gnxlxnxx/christmas_card_25/bell/bell-lib/2340901-1--3DModel-STEP-78480.STEP

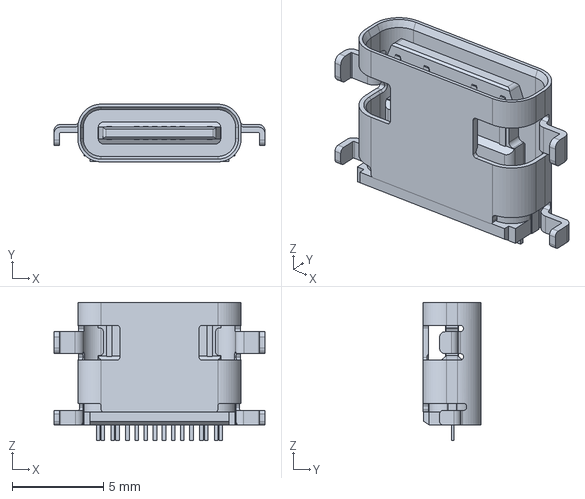
[picture p1: CAD file, 2025-12-08]
bell/bell-lib/2340901-1--3DModel-STEP-78480.STEP
11.5 x 3.16 x 7.55 mm
