gnxlxnxx/christmas_card_25/bell/bell.pdf

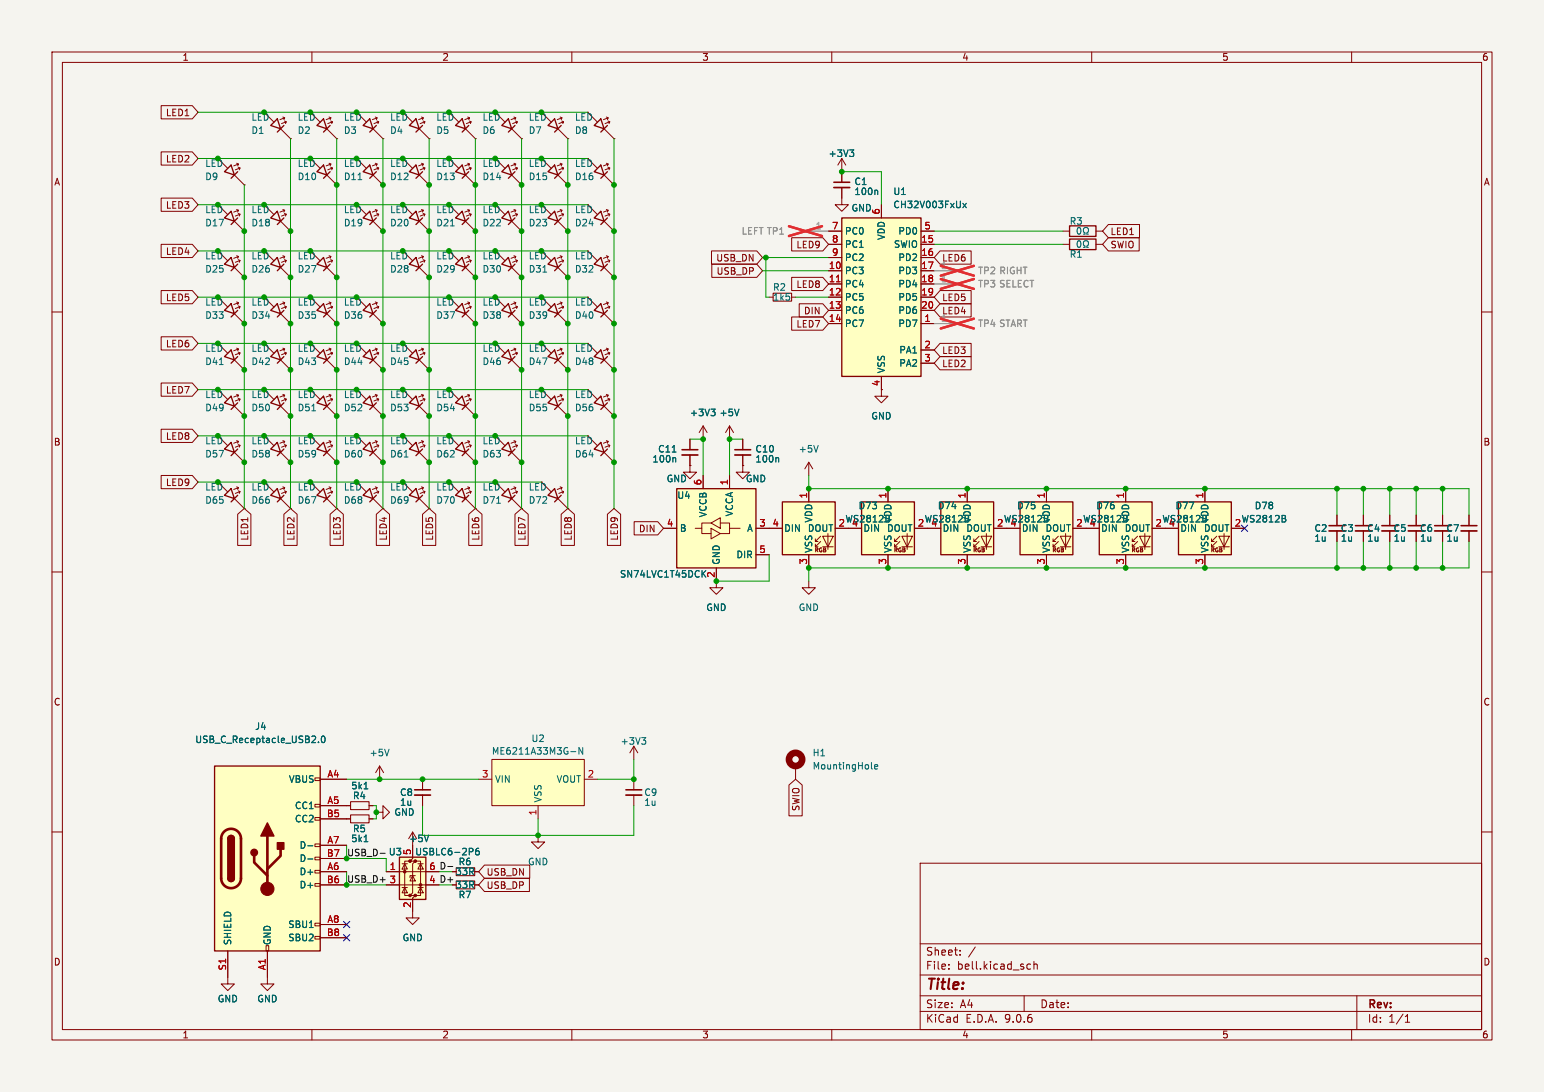
[picture p2: page 1]

4 PD0 5 SWIO 15 PD2 16 PD3 17 PD4 18 PD5 19 PD6 20 PD7 1 PA1 2 PA2 3 TP4 START 1 TP3 SELECT 1 TP2 RIGHT 1

3 DOUT 2 D74 WS2812B SHIELD S1 GND A1 VBUS A4 CC1 A5 CC2 B5 D- A7 D- B7 D+ A6 D+ B6 SBU1 A8 SBU2 B8
