gnxlxnxx/christmas_card_25/bell/bell.kicad_pcb

## KiCad design bell/bell.kicad_pcb (2025-12-26)

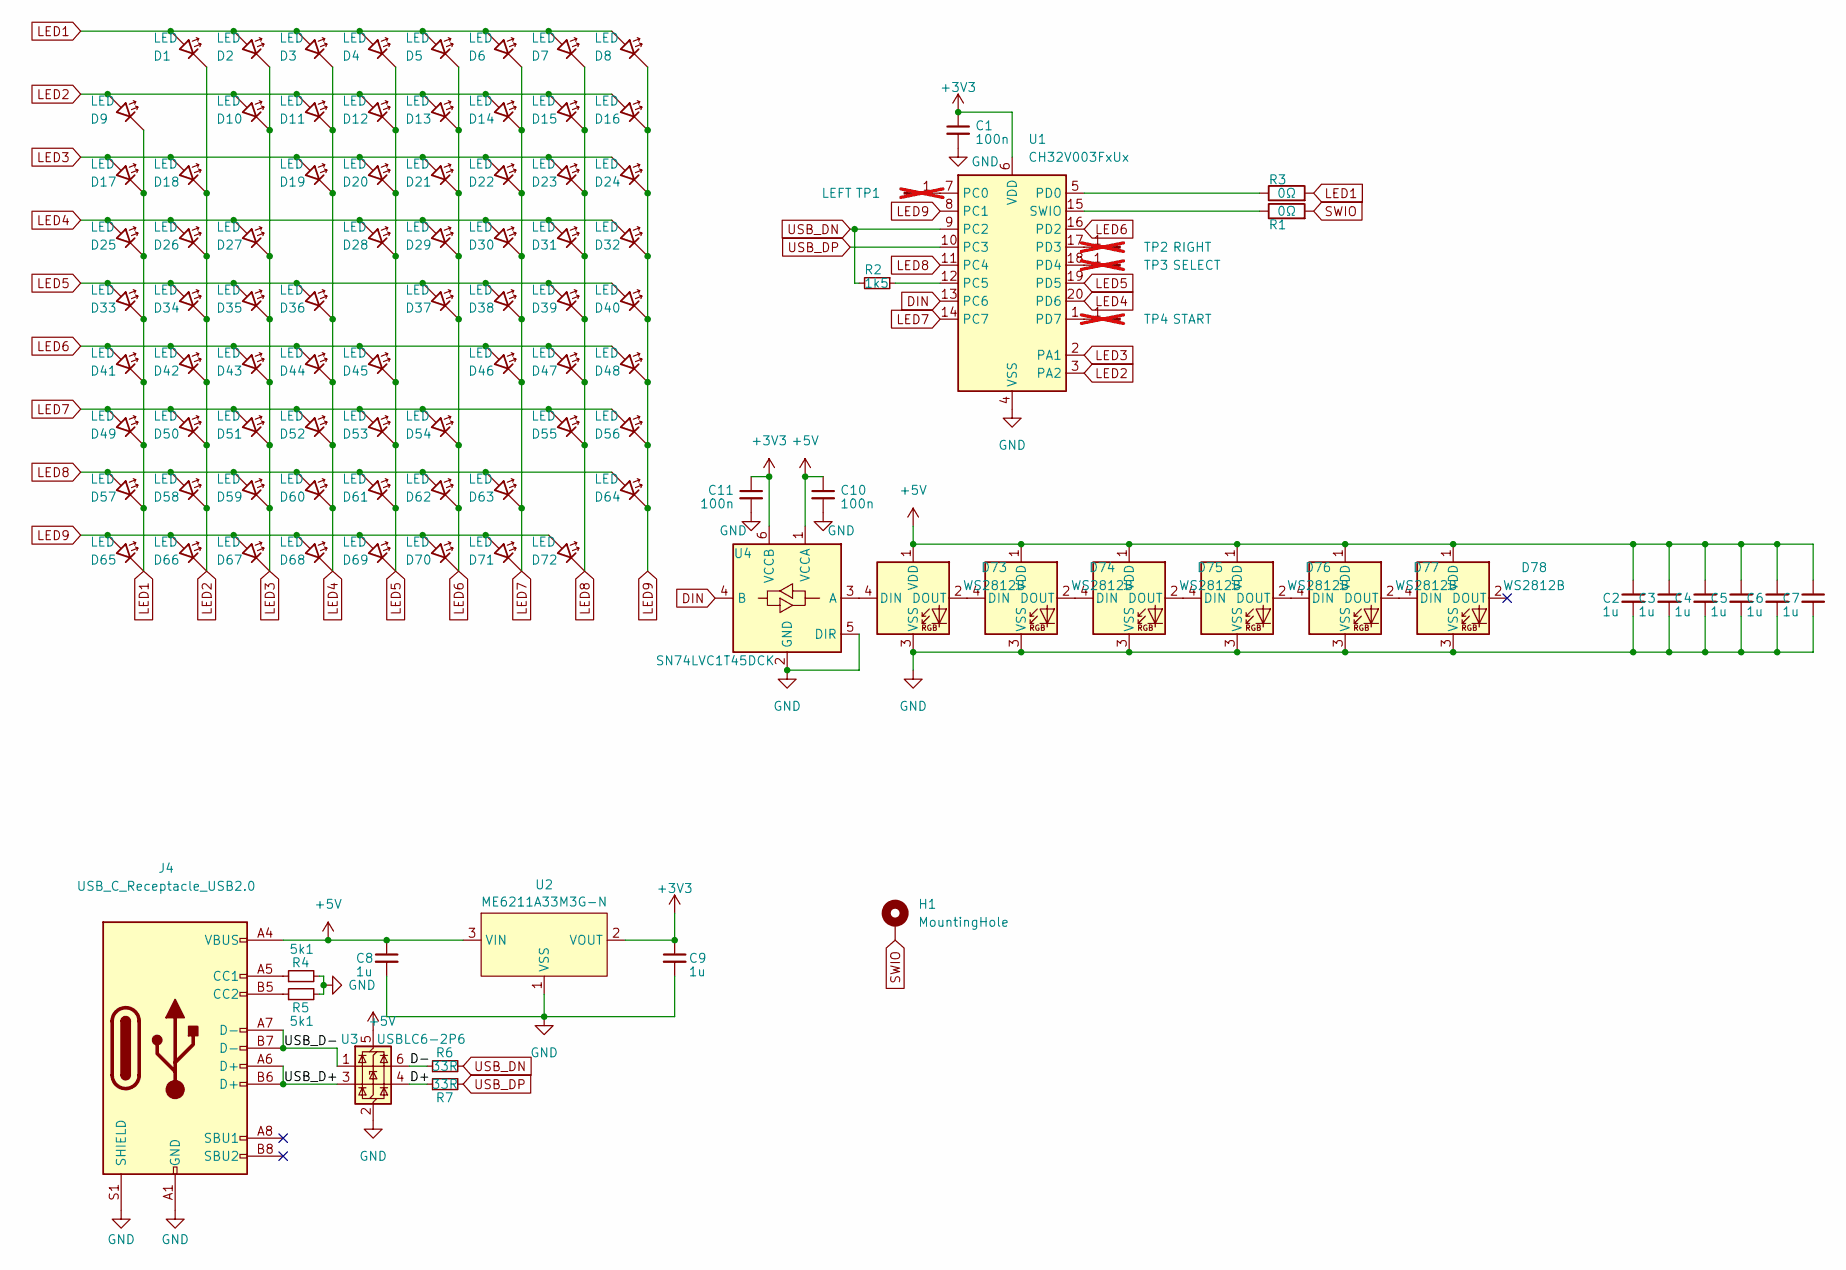
[picture p3: schematic bell.kicad_sch]

Parts:
C1, C10, C11: 100n; C_0402_1005Metric; LCSC C1525
C2, C3, C4, C5, C6, C7, C8, C9: 1u; C_0402_1005Metric; LCSC C52923
D1, D2, D3, D4, D5, D6, D7, D8, D9, D10, D11, D12, D13, D14, D15, D16, D17, D18, D19, D20, D21, D22, D23, D24, D25, D26, D27, D28, D29, D30, D31, D32, D33, D34, D35, D36, D37, D38, D39, D40, D41, D42, D43, D44, D45, D46, D47, D48, D49, D50, D51, D52, D53, D54, D55, D56, D57, D58, D59, D60, D61, D62, D63, D64, D65, D66, D67, D68, D69, D70, D71, D72: LED; LED_0603_1608Metric_Pad1.05x0.95mm_HandSolder; LCSC C497938
D73, D74, D75, D76, D77, D78: WS2812B; LED_WS2812B_PLCC4_5.0x5.0mm_P3.2mm; LCSC C965555
H1: MountingHole; MountingHole_3.2mm_M3_DIN965_Pad
J4: USB_C_Receptacle_USB2.0; TYPE C 16 PIN MIDDLE MOUNT CH 0.52; LCSC C2927036
R1, R3: 0Ω; R_0402_1005Metric; LCSC C17168
R2: 1k5; R_0402_1005Metric; LCSC C25867
R4, R5: 5k1; R_0402_1005Metric; LCSC C25905
R6, R7: 33R; R_0402_1005Metric; LCSC C25105
TP1: LEFT; touchbutton; not fitted
TP2: RIGHT; touchbutton; not fitted
TP3: SELECT; uni-logo; not fitted
TP4: START; uni-logo; not fitted
U1: CH32V003FxUx; QFN-20-1EP_3x3mm_P0.4mm_EP1.65x1.65mm; LCSC C5299908
U2: ME6211A33M3G-N; SOT-23-3; LCSC C168807
U3: USBLC6-2P6; SOT-666; LCSC C2827693
U4: SN74LVC1T45DCK; SOT-363_SC-70-6; LCSC C80768

Connections:
+3V3: C1.1, C9.1, C11.1, U1.6 (VDD), U2.2 (VOUT), U4.6 (VCCB)
+5V: C2.1, C3.1, C4.1, C5.1, C6.1, C7.1, C8.1, C10.1, D73.1 (VDD), D74.1 (VDD), D75.1 (VDD), D76.1 (VDD), D77.1 (VDD), D78.1 (VDD), J4.A4 (VBUS), J4.A9 (VBUS), J4.B4 (VBUS), J4.B9 (VBUS), U2.3 (VIN), U3.5 (VBUS), U4.1 (VCCA)
/D+: R7.1, U3.4 (I/O2)
/D-: R6.1, U3.6 (I/O1)
/USB_D+: J4.A6 (D+), J4.B6 (D+), U3.3 (I/O2)
/USB_D-: J4.A7 (D-), J4.B7 (D-), U3.1 (I/O1)
DIN: U1.13 (PC6), U4.4 (B)
GND: C1.2, C2.2, C3.2, C4.2, C5.2, C6.2, C7.2, C8.2, C9.2, C10.2, C11.2, D73.3 (VSS), D74.3 (VSS), D75.3 (VSS), D76.3 (VSS), D77.3 (VSS), D78.3 (VSS), J4.A1 (GND), J4.A12 (GND), J4.B1 (GND), J4.B12 (GND), J4.S1 (SHIELD), R4.2, R5.2, U1.4 (VSS), U1.21 (VSS), U2.1 (VSS), U3.2 (GND), U4.2 (GND), U4.5 (DIR)
LED1: D1.2 (A), D2.2 (A), D3.2 (A), D4.2 (A), D5.2 (A), D6.2 (A), D7.2 (A), D8.2 (A), D9.1 (K), D17.1 (K), D25.1 (K), D33.1 (K), D41.1 (K), D49.1 (K), D57.1 (K), D65.1 (K), R3.2
LED2: D1.1 (K), D9.2 (A), D10.2 (A), D11.2 (A), D12.2 (A), D13.2 (A), D14.2 (A), D15.2 (A), D16.2 (A), D18.1 (K), D26.1 (K), D34.1 (K), D42.1 (K), D50.1 (K), D58.1 (K), D66.1 (K), U1.3 (PA2)
LED3: D2.1 (K), D10.1 (K), D17.2 (A), D18.2 (A), D19.2 (A), D20.2 (A), D21.2 (A), D22.2 (A), D23.2 (A), D24.2 (A), D27.1 (K), D35.1 (K), D43.1 (K), D51.1 (K), D59.1 (K), D67.1 (K), U1.2 (PA1)
LED4: D3.1 (K), D11.1 (K), D19.1 (K), D25.2 (A), D26.2 (A), D27.2 (A), D28.2 (A), D29.2 (A), D30.2 (A), D31.2 (A), D32.2 (A), D36.1 (K), D44.1 (K), D52.1 (K), D60.1 (K), D68.1 (K), U1.20 (PD6)
LED5: D4.1 (K), D12.1 (K), D20.1 (K), D28.1 (K), D33.2 (A), D34.2 (A), D35.2 (A), D36.2 (A), D37.2 (A), D38.2 (A), D39.2 (A), D40.2 (A), D45.1 (K), D53.1 (K), D61.1 (K), D69.1 (K), U1.19 (PD5)
LED6: D5.1 (K), D13.1 (K), D21.1 (K), D29.1 (K), D37.1 (K), D41.2 (A), D42.2 (A), D43.2 (A), D44.2 (A), D45.2 (A), D46.2 (A), D47.2 (A), D48.2 (A), D54.1 (K), D62.1 (K), D70.1 (K), U1.16 (PD2)
LED7: D6.1 (K), D14.1 (K), D22.1 (K), D30.1 (K), D38.1 (K), D46.1 (K), D49.2 (A), D50.2 (A), D51.2 (A), D52.2 (A), D53.2 (A), D54.2 (A), D55.2 (A), D56.2 (A), D63.1 (K), D71.1 (K), U1.14 (PC7)
LED8: D7.1 (K), D15.1 (K), D23.1 (K), D31.1 (K), D39.1 (K), D47.1 (K), D55.1 (K), D57.2 (A), D58.2 (A), D59.2 (A), D60.2 (A), D61.2 (A), D62.2 (A), D63.2 (A), D64.2 (A), D72.1 (K), U1.11 (PC4)
LED9: D8.1 (K), D16.1 (K), D24.1 (K), D32.1 (K), D40.1 (K), D48.1 (K), D56.1 (K), D64.1 (K), D65.2 (A), D66.2 (A), D67.2 (A), D68.2 (A), D69.2 (A), D70.2 (A), D71.2 (A), D72.2 (A), U1.8 (PC1)
unnamed: D73.4 (DIN), U4.3 (A)
unnamed: D73.2 (DOUT), D74.4 (DIN)
unnamed: D74.2 (DOUT), D75.4 (DIN)
unnamed: D75.2 (DOUT), D76.4 (DIN)
unnamed: D76.2 (DOUT), D77.4 (DIN)
unnamed: D77.2 (DOUT), D78.4 (DIN)
unnamed: J4.A5 (CC1), R4.1
unnamed: J4.B5 (CC2), R5.1
unnamed 25: TP1.1, U1.7 (PC0); also elsewhere on the board
unnamed 26: TP2.1, U1.17 (PD3); also elsewhere on the board
unnamed: TP3.1, U1.18 (PD4)
unnamed: TP4.1, U1.1 (PD7)
unnamed: R2.1, U1.12 (PC5)
unnamed: R3.1, U1.5 (PD0)
unnamed: R1.1, U1.15 (SWIO)
SWIO: H1.1, R1.2
USB_DN: R2.2, R6.2, U1.9 (PC2)
USB_DP: R7.2, U1.10 (PC3)

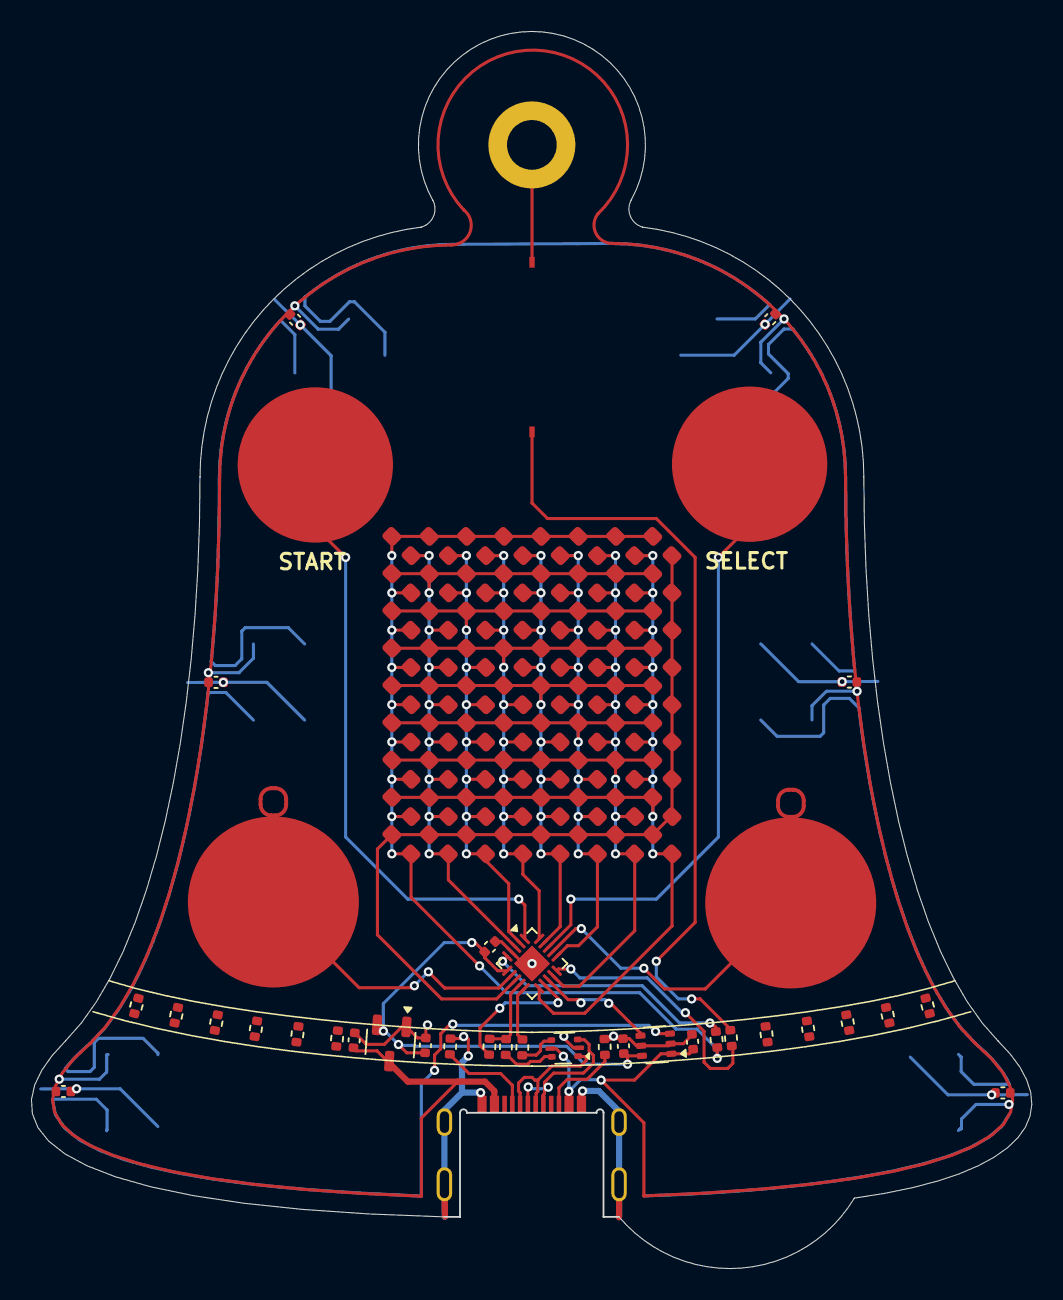
[picture p4: board bell.kicad_pcb from above]

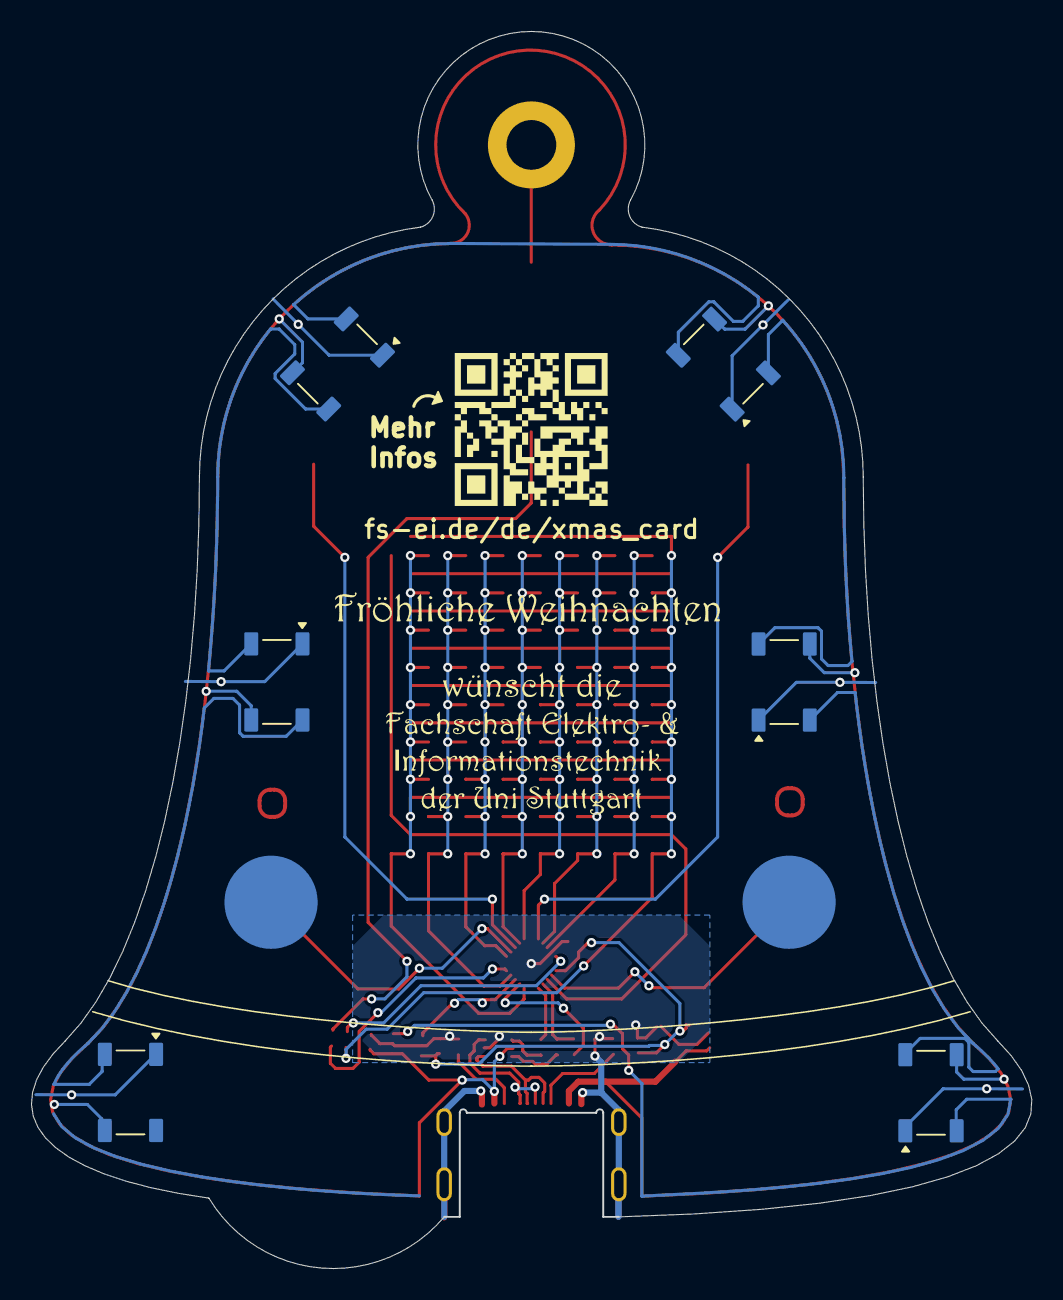
[picture p5: board bell.kicad_pcb from below]

Board: 2 copper layers, 64.4 x 79.6 mm, 119 parts (8 on the bottom side), 35 nets.

Other parts of the board:
J6, J6#2: Touchpad1; touch_pad
R10, R11, R12, R13, R14, R15, R16, R17, R18, R19, R20: 0Ω; R_0402_1005Metric
TP10: RIGHT; touchbutton
TP10#2: LEFT; touchbutton

Their connections:
unnamed 25: J6#2.1; also elsewhere on the board
unnamed 26: J6.1; also elsewhere on the board
