gnxlxnxx/christmas_card_25/firmware/src/ws2812.rs

use ch32_hal as hal;
use core::mem;
use embedded_hal::spi::SpiBus;
use hal::spi::{Config, Instance, Spi, TxDma};
use hal::{Peri, peripherals};
use hal::{dma, dma::Channel};

const BITQUARTETS: [u16; 16] = [
    0b1000100010001000,
    0b1000100010001110,
    0b1000100011101000,
    0b1000100011101110,
    0b1000111010001000,
    0b1000111010001110,
    0b1000111011101000,
    0b1000111011101110,
    0b1110100010001000,
    0b1110100010001110,
    0b1110100011101000,
    0b1110100011101110,
    0b1110111010001000,
    0b1110111010001110,
    0b1110111011101000,
    0b1110111011101110,
];

#[derive(Clone, Copy)]
pub struct Color {
    pub r: u8,
    pub g: u8,
    pub b: u8,
}

impl Color {
    pub fn new(r: u8, g: u8, b: u8) -> Self {
        Self { r, g, b }
    }

    fn to_slices_grb(&self) -> [u16; 6] {
        let mut result: [u16; 6] = [0; 6];
        result[0] = BITQUARTETS[(self.g >> 4) as usize];
        result[1] = BITQUARTETS[(self.g & 0xF) as usize];
        result[2] = BITQUARTETS[(self.r >> 4) as usize];
        result[3] = BITQUARTETS[(self.r & 0xF) as usize];
        result[4] = BITQUARTETS[(self.b >> 4) as usize];
        result[5] = BITQUARTETS[(self.b & 0xF) as usize];
        result
    }
}

pub struct Ws2812<'a> {
    spi: Spi<'a, peripherals::SPI1, ch32_hal::mode::Async>,
    // spi: Spi<'a, peripherals::SPI1, ch32_hal::mode::Blocking>,
}

impl<'a> Ws2812<'a> {
    pub fn init(
        pin: Peri<'static, peripherals::PC6>,
        spi1: Peri<'static, peripherals::SPI1>,
        dma1_ch3: Peri<'static, peripherals::DMA1_CH3>,
    ) -> Self {
        let mut spi_config = Config::default();
        spi_config.mode = embedded_hal::spi::MODE_0; // CPOL LOW, CPHA

        spi_config.frequency = hal::prelude::Hertz::hz(3_000_000);

        let mut spi = Spi::new_txonly_nosck::<0>(spi1, pin, dma1_ch3, spi_config);
        // let mut spi = Spi::new_blocking_txonly_nosck::<0>(spi1, pin, spi_config);

        // TODO: The C impl has this but this is for reading, do I really need this here?
        //        hal::pac::SPI1.hscr().write(|w| w.set_hsrxen(true));

        // let mut foo = [0; 36];

        // foo[12..18].clone_from_slice(&Color::new(0, 0, 0).to_slices_grb());
        // foo[18..24].clone_from_slice(&Color::new(0, 0, 0).to_slices_grb());
        // foo[24..30].clone_from_slice(&Color::new(0, 0, 0).to_slices_grb());

        // spi.write::<u16>(&foo).await;

        Self { spi }
    }

    pub async fn start(&mut self, colors: [Color; 6]) {
        // let color1 = Color::new(0x08, 0, 0).to_slices_grb();
        // let color2 = Color::new(0, 0x08, 0).to_slices_grb();
        // let color3 = Color::new(0, 0, 0x08).to_slices_grb();

        // I have 2 leading and one trailing led full of '0's
        let mut foo = [0; (6 + 3) * 6];

        foo[12..18].clone_from_slice(&colors[0].to_slices_grb());
        foo[18..24].clone_from_slice(&colors[1].to_slices_grb());
        foo[24..30].clone_from_slice(&colors[2].to_slices_grb());
        foo[30..36].clone_from_slice(&colors[3].to_slices_grb());
        foo[36..42].clone_from_slice(&colors[4].to_slices_grb());
        foo[42..48].clone_from_slice(&colors[5].to_slices_grb());

        self.spi.write::<u16>(&foo).await.unwrap(); // surely this unwrap will never fail ...
        // TODO: I don't know why yet, but the first led doesn't get set the very first time
        self.spi.write::<u16>(&foo).await.unwrap(); // surely this unwrap will never fail ...
    }
}

pub const HUETABLE: [u8; 256] = [
    0x00, 0x06, 0x0c, 0x12, 0x18, 0x1e, 0x24, 0x2a, 0x30, 0x36, 0x3c, 0x42, 0x48, 0x4e, 0x54, 0x5a,
    0x60, 0x66, 0x6c, 0x72, 0x78, 0x7e, 0x84, 0x8a, 0x90, 0x96, 0x9c, 0xa2, 0xa8, 0xae, 0xb4, 0xba,
    0xc0, 0xc6, 0xcc, 0xd2, 0xd8, 0xde, 0xe4, 0xea, 0xf0, 0xf6, 0xff, 0xff, 0xff, 0xff, 0xff, 0xff,
    0xff, 0xff, 0xff, 0xff, 0xff, 0xff, 0xff, 0xff, 0xff, 0xff, 0xff, 0xff, 0xff, 0xff, 0xff, 0xff,
    0xff, 0xff, 0xff, 0xff, 0xff, 0xff, 0xff, 0xff, 0xff, 0xff, 0xff, 0xff, 0xff, 0xff, 0xff, 0xff,
    0xff, 0xff, 0xff, 0xff, 0xff, 0xff, 0xff, 0xff, 0xff, 0xff, 0xff, 0xff, 0xff, 0xff, 0xff, 0xff,
    0xff, 0xff, 0xff, 0xff, 0xff, 0xff, 0xff, 0xff, 0xff, 0xff, 0xff, 0xff, 0xff, 0xff, 0xff, 0xff,
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
    0xac, 0x86, 0x21, 0x2b, 0xaa, 0x1a, 0x55, 0xa2, 0xbe, 0x70, 0xb5, 0x73, 0x3b, 0x04, 0x5c, 0xd3,
    0x36, 0x94, 0xb3, 0xaf, 0xe2, 0xf0, 0xe4, 0x9e, 0x4f, 0x32, 0x15, 0x49, 0xfd, 0x82, 0x4e, 0xa9,
];
