gnxlxnxx/christmas_card_25/firmware/src/drivers/ws2812.rs

use core::sync::atomic::{Ordering, compiler_fence};

use ch32_metapac::{self as pac, Interrupt};
use qingke::pfic;

pub const LEDS: usize = 6;

const BITQUARTETS: [u16; 16] = [
    0b1000100010001000,
    0b1000100010001110,
    0b1000100011101000,
    0b1000100011101110,
    0b1000111010001000,
    0b1000111010001110,
    0b1000111011101000,
    0b1000111011101110,
    0b1110100010001000,
    0b1110100010001110,
    0b1110100011101000,
    0b1110100011101110,
    0b1110111010001000,
    0b1110111010001110,
    0b1110111011101000,
    0b1110111011101110,
];

// I have 2 leading and one trailing led full of '0's
static mut SPI_DMA_BUF: [[u16; 6]; LEDS + 3] = [[0; 6]; LEDS + 3];

#[derive(Clone, Copy, PartialEq, Eq)]
pub struct Color([u8; 3]);

impl Color {
    #[must_use]
    pub fn new(r: u8, g: u8, b: u8) -> Self {
        Self([g, r, b])
    }

    #[must_use]
    pub fn r(&self) -> u8 {
        self.0[1]
    }

    #[must_use]
    pub fn g(&self) -> u8 {
        self.0[0]
    }

    #[must_use]
    pub fn b(&self) -> u8 {
        self.0[2]
    }

    pub fn set_r(&mut self, val: u8) {
        self.0[1] = val;
    }

    pub fn set_g(&mut self, val: u8) {
        self.0[0] = val;
    }

    pub fn set_b(&mut self, val: u8) {
        self.0[2] = val;
    }

    pub fn transition(&mut self, desired_value: &Self) {
        for (cur, target) in self.0.iter_mut().zip(desired_value.0) {
            if target > *cur {
                *cur += 1;
            } else if target < *cur {
                *cur -= 1;
            }
        }
    }

    fn gen_grb_data(&self, buf: &mut [u16; 6]) {
        for (val, data) in self.0.iter().zip(buf.chunks_exact_mut(2)) {
            data[0] = BITQUARTETS[(val >> 4) as usize];
            data[1] = BITQUARTETS[(val & 0xf) as usize];
        }
    }
}

pub struct Ws2812 {
    _private: (),
}

impl Ws2812 {
    #[must_use]
    pub unsafe fn init() -> Self {
        // Remap is implicitly set as 0
        pac::GPIOC.cfglr().modify(|w| {
            w.set_mode(6, pac::gpio::vals::Mode::OUTPUT_10MHZ);
            w.set_cnf(6, pac::gpio::vals::Cnf::PULL_IN__AF_PUSH_PULL_OUT);
        });

        pac::RCC.ahbpcenr().modify(|w| w.set_dma1en(true));
        pac::RCC.apb2pcenr().modify(|w| w.set_spi1en(true));

        pac::SPI1.ctlr2().write(|w| {
            w.set_ssoe(false);
            w.set_txdmaen(true);
        });
        pac::SPI1.ctlr1().write(|w| {
            w.set_mstr(true); // master
            w.set_br(pac::spi::vals::BaudRate::DIV_16);
            w.set_spe(true); // Enable SPI
            // w.set_lsbfirst(config.lsb_first());
            w.set_ssi(true);
            w.set_ssm(true);
            w.set_crcen(false);
            w.set_bidimode(false); // undirectional output TODO might make sense to use bidimode, output only?
            w.set_rxonly(false);
            w.set_dff(true); // send/receive u16
        });

        unsafe { pfic::pend_interrupt(Interrupt::DMA1_CHANNEL3 as u8); }

        Self { _private: () }
    }

    #[must_use]
    pub fn ready(&self) -> bool {
        pfic::is_pending(Interrupt::DMA1_CHANNEL3 as u8) && !pac::SPI1.statr().read().bsy()
    }

    pub fn try_write(&mut self, colors: &[Color; LEDS]) -> bool {
        // Wait for previous SPI to be done
        if !self.ready() {
            return false;
        }
        unsafe { pfic::unpend_interrupt(Interrupt::DMA1_CHANNEL3 as u8); }
        compiler_fence(Ordering::Acquire);

        #[allow(static_mut_refs)]
        let spi_dma_buf = unsafe { &mut SPI_DMA_BUF };

        for (signal, color) in spi_dma_buf[2..LEDS + 2].iter_mut().zip(colors) {
            color.gen_grb_data(signal);
        }

        let tx_dst = pac::SPI1.datar().as_ptr();
        let ch = pac::DMA1.ch(3 - 1);
        ch.par().write_value(tx_dst as u32); // PADDR
        ch.mar().write_value(spi_dma_buf.as_flattened().as_ptr() as u32); // MADDR
        ch.ndtr().write(|w| w.set_ndt(spi_dma_buf.as_flattened().len() as u16)); // CNTR

        compiler_fence(Ordering::Release);
        ch.cr().write(|w| {
            w.set_psize(pac::dma::vals::Size::BITS16);
            w.set_msize(pac::dma::vals::Size::BITS16);
            w.set_minc(true); // Increase memory address
            w.set_dir(pac::dma::vals::Dir::FROMMEMORY);
            w.set_teie(false); // no interrupt on errror
            w.set_tcie(true); // interrupt on tx complete
            w.set_htie(false); // no interrupt half
            w.set_circ(false); // circular
            //w.set_pl(options.priority.into()); // priority
            w.set_en(true); // and start
        });

        true
    }
}
