gnxlxnxx/christmas_card_25/firmware/src/vectors.rs

mod _vectors {
    unsafe extern "C" {
        fn WWDG();
        fn PVD();
        fn FLASH();
        fn RCC();
        fn EXTI7_0_IRQHandler();
        fn AWU();
        fn DMA1_CHANNEL1();
        fn DMA1_CHANNEL2();
        fn DMA1_CHANNEL3();
        fn DMA1_CHANNEL4();
        fn DMA1_CHANNEL5();
        fn DMA1_CHANNEL6();
        fn DMA1_CHANNEL7();
        fn ADC();
        fn I2C1_EV();
        fn I2C1_ER();
        fn USART1();
        fn SPI1();
        fn TIM1_BRK();
        fn TIM1_UP();
        fn TIM1_TRG_COM();
        fn TIM1_CC();
        fn TIM2();
    }
    pub union Vector {
        _handler: unsafe extern "C" fn(),
        _reserved: u32,
    }
    #[unsafe(link_section = ".vector_table.external_interrupts_usb")]
    #[unsafe(no_mangle)]
    pub static __EXTERNAL_INTERRUPTS_USB: [Vector; 23] = [
        Vector { _handler: WWDG },
        Vector { _handler: PVD },
        Vector { _handler: FLASH },
        Vector { _handler: RCC },
        Vector {
            _handler: EXTI7_0_IRQHandler,
        },
        Vector { _handler: AWU },
        Vector {
            _handler: DMA1_CHANNEL1,
        },
        Vector {
            _handler: DMA1_CHANNEL2,
        },
        Vector {
            _handler: DMA1_CHANNEL3,
        },
        Vector {
            _handler: DMA1_CHANNEL4,
        },
        Vector {
            _handler: DMA1_CHANNEL5,
        },
        Vector {
            _handler: DMA1_CHANNEL6,
        },
        Vector {
            _handler: DMA1_CHANNEL7,
        },
        Vector { _handler: ADC },
        Vector { _handler: I2C1_EV },
        Vector { _handler: I2C1_ER },
        Vector { _handler: USART1 },
        Vector { _handler: SPI1 },
        Vector { _handler: TIM1_BRK },
        Vector { _handler: TIM1_UP },
        Vector {
            _handler: TIM1_TRG_COM,
        },
        Vector { _handler: TIM1_CC },
        Vector { _handler: TIM2 },
    ];
}
