gnxlxnxx/christmas_card_25/(commit log)

2025-12-08 export schematic as pdf
    [bell.kicad_sch]
2025-12-18 Get first matrix prototype to work
    Better start commiting now, before I accidently break it during cleanup
2025-12-19 Fix input capturing
    Somewhere, hidden deep within the CH32V003 Reference Manual:
    > Note: Compare Capture Channel 2 is writable only
    > when the channel is off (when CC2E is zero).
    [matrix.rs]
2025-12-20 Optimize timer ISR
2025-12-20 Finish button driver
2025-12-20 Refactor timer driver
2025-12-20 add ws2812 leds
2025-12-26 Partially revert "let rustfmt fmt rust"
    This partially reverts commit e5f715a7ef2ec48d02010a38eb5dfb876be6f6d2.
    [buttons.rs, main.rs, matrix.rs, mod.rs]
2025-12-26 Remove not working auto mode
    [mod.rs]
2025-12-26 Revert size regressing code improvement
    [rand_pulse.rs]
2025-12-26 Move button sample processing to interrupt in order to save flash
2025-12-30 Replace bloated embassy sync structures through custom spinloop based ones
    [buttons.rs, main.rs, mod.rs, time.rs]
2026-01-01 Improve timer driver
2026-01-03 Move to hand-coded DMA
2026-01-03 Re-add interrupt priority setting
2026-01-03 Rework text utilities
    Saves ~250 bytes
    [mod.rs]
2026-01-08 Fix text not rendering lowest two rows
    [mod.rs]
2026-01-08 Use registers directly for timer configuration
2026-01-08 Remove dma interrupt
2026-01-08 Fix leds being slightly turned on that shouldn’t
    [mod.rs]
2026-01-09 Use ch32-hal variant without dma init
2026-01-09 Move usb code to drivers module
2026-01-09 Move tetris board to boolean
2026-01-09 Move tetris board to u8 as row
    Saves exactly 100 bytes
2026-01-09 Halve sine table by using the symmetrical properties of sine
    Saves ~100 bytes
    Further halving didn't save anything in my testing
    [mod.rs]
2026-01-09 Increase button sensitivity
2026-01-11 Implement backwards button for game menu
2026-01-11 Optimize button event passing
2026-01-11 Add ws2812 button animation for game app
2026-01-11 Remap game menu buttons
2026-01-11 Make dma (hopefully) safe and sound
2026-01-11 Simplify dma function
2026-01-12 Decrease button sensitivity to prevent phantom input
    [buttons.rs]
2026-01-12 Hopefully fix flash issues
    [flash.rs]
2026-01-12 Allow out of bounds rotation at the top of the board in tetris
2026-01-21 Save space by using u8 for port/pin ids
2026-01-25 Fix small bugs from non-async conversion
    [mod.rs]
2026-03-15 Discard button events during pong score screen
